lingetech/FacileFOC/硬件/数据手册/README.md

1. 提供的数据手册仅供参考，可能存在更新的数据手册。  
2. CP2102_9 Data Sheet - C6568_USB转换芯片_CP2102-GMR_规格书_WJ205709.PDF.pdf  
   是  
   C6568_USB转换芯片_CP2102-GMR_规格书_WJ205709.pdf  
   的机翻，不保证翻译准确性。
