lingetech/FacileFOC/硬件/无刷电机控制器v2.8/SCH_编码器板_2026-01-30.pdf

Direction polarity (GND = values increase clockwise,

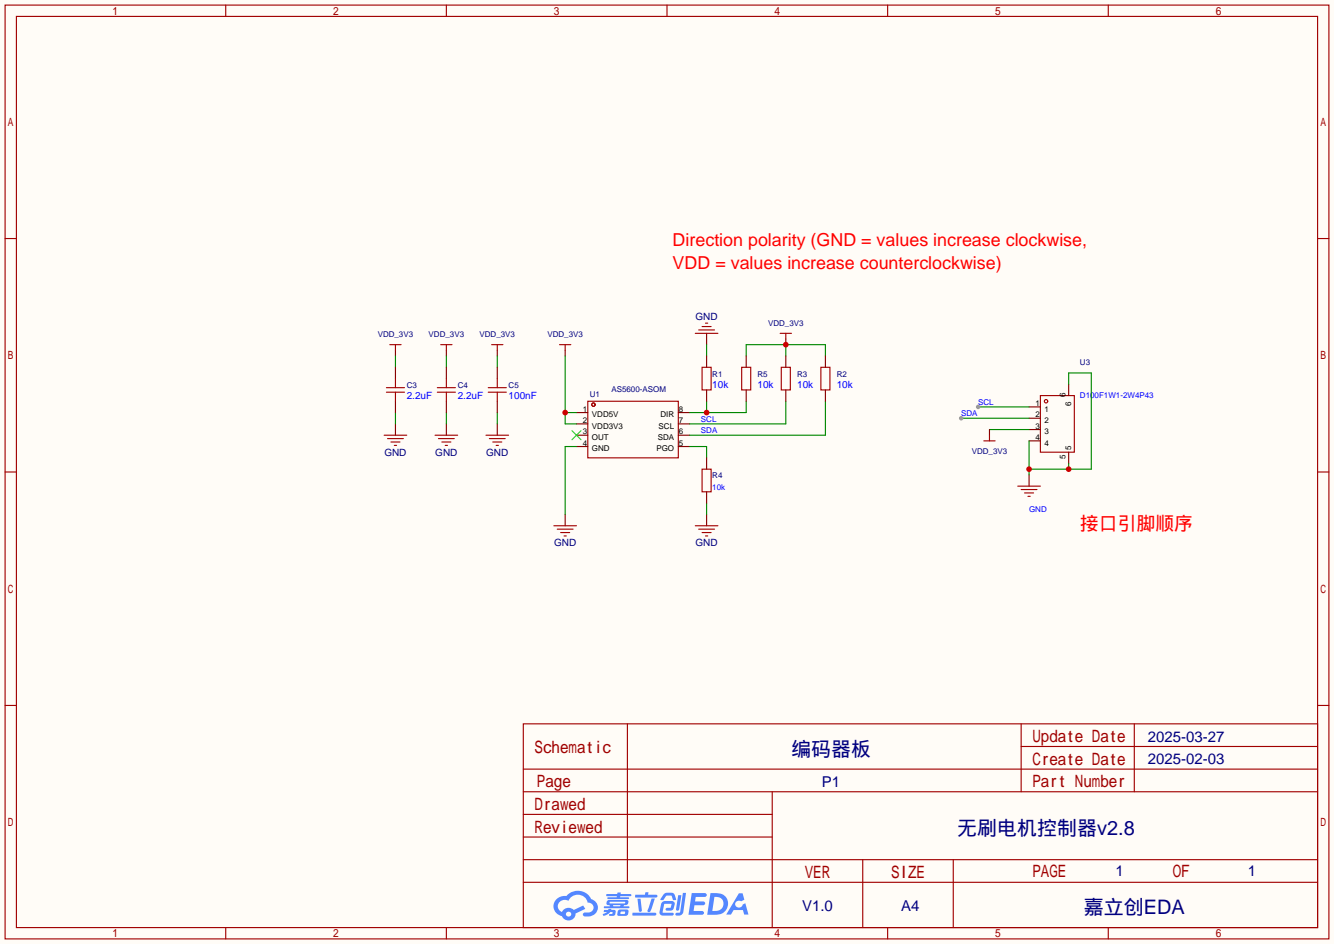
[picture p1: page 1]

VDD = values increase counterclockwise)
