lingetech/FacileFOC/硬件/无刷电机控制器v2.8/SCH_驱动板_2026-01-30.pdf

# VBUS B9 SBU2 B8 DN2 B7 DP2 B6 CC2 B5 VBUS B4

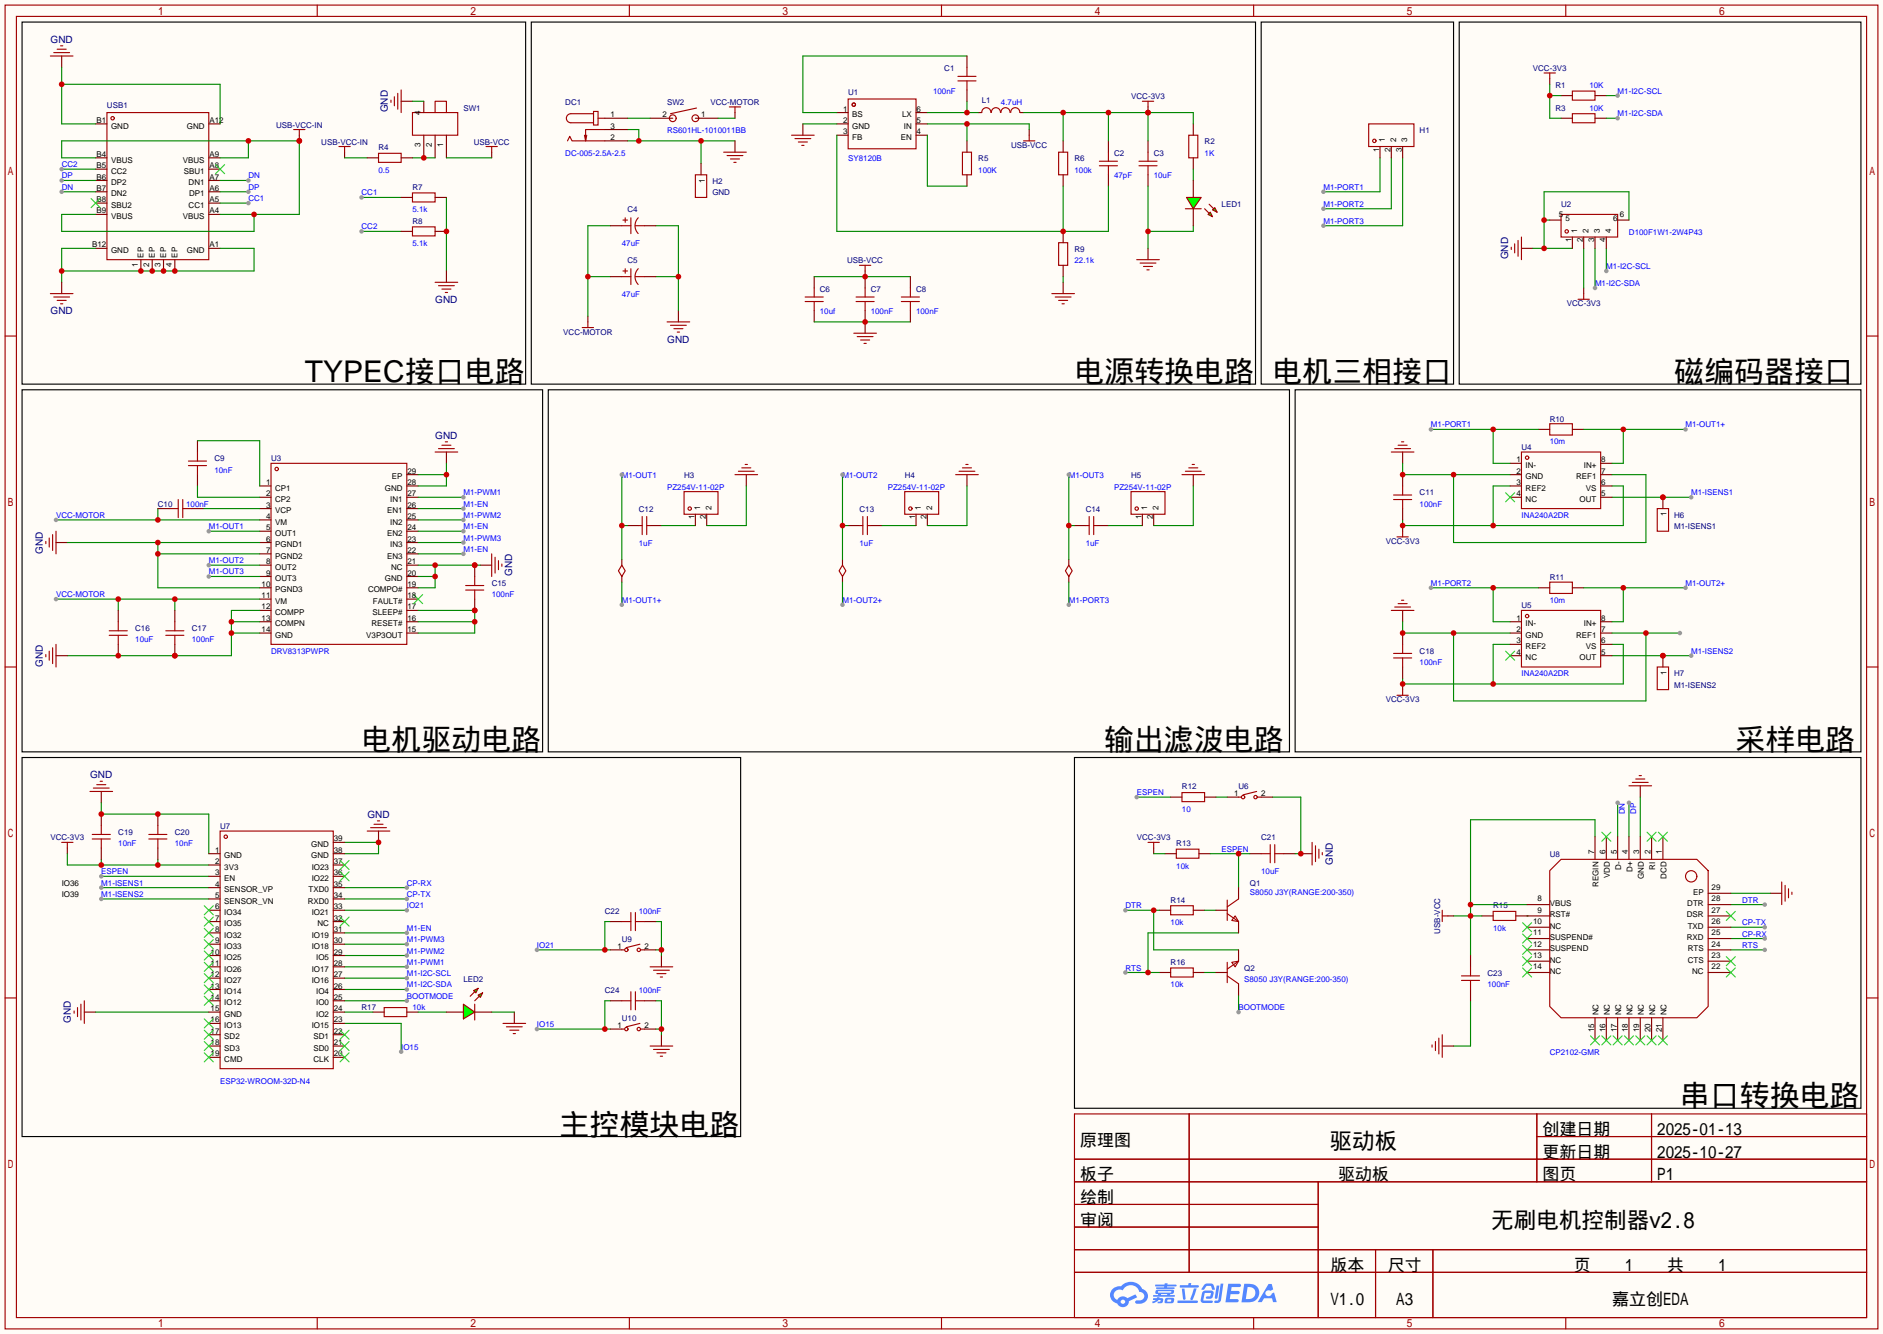
[picture p2: page 1]

原理图 | 驱动板 | 创建日期 | 2025-01-13

更新日期 | 2025-10-27

板子 | 驱动板 | 图页 | P1
绘制 | | 无刷电机控制器v2.8
审阅

V1.0 | A3 | 嘉立创EDA
