lingetech/FacileFOC/(commit log)

2026-01-30 Create 硬件folder
2026-01-30 add 无刷电机控制器v2.8.eprj2
2026-01-30 Create 数据手册folder
